orderinnchaoss/CANSAT-18/Team Kalpana-1.jpg

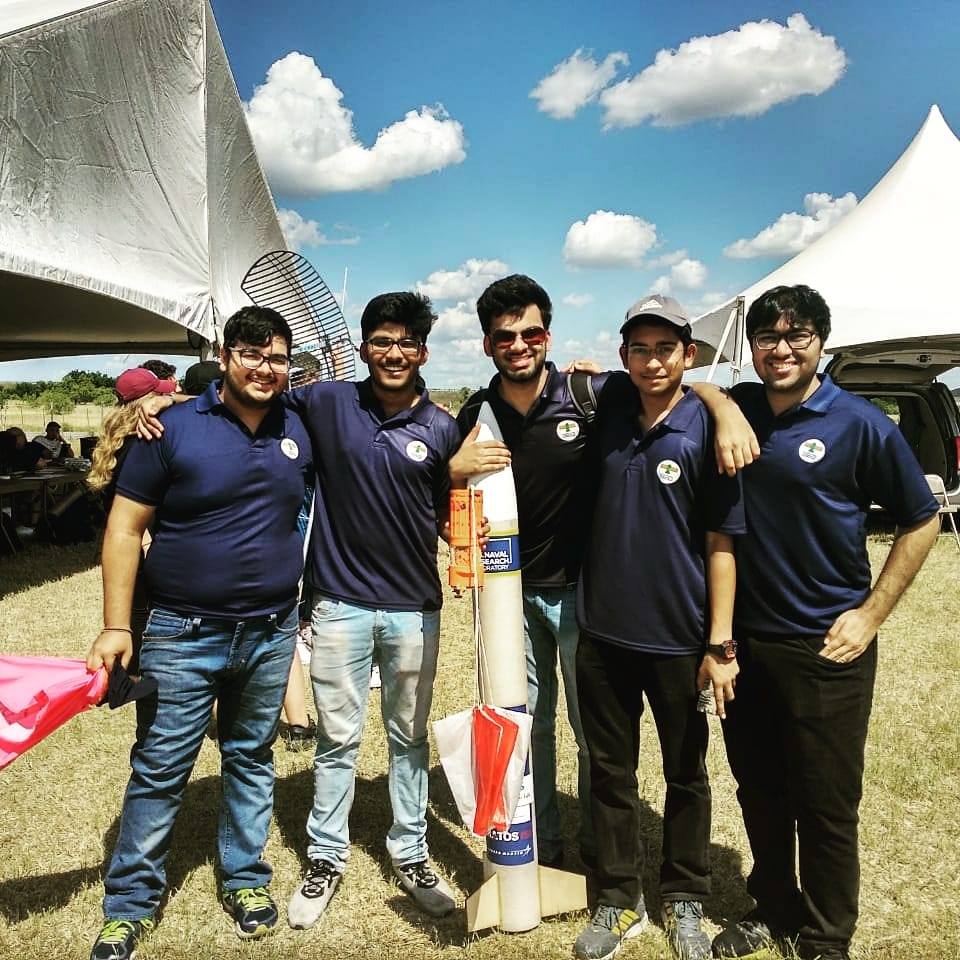
Team Kalpana-1.jpg
