orderinnchaoss/CANSAT-18/Cansat2018_2426_PFR_v01.pdf

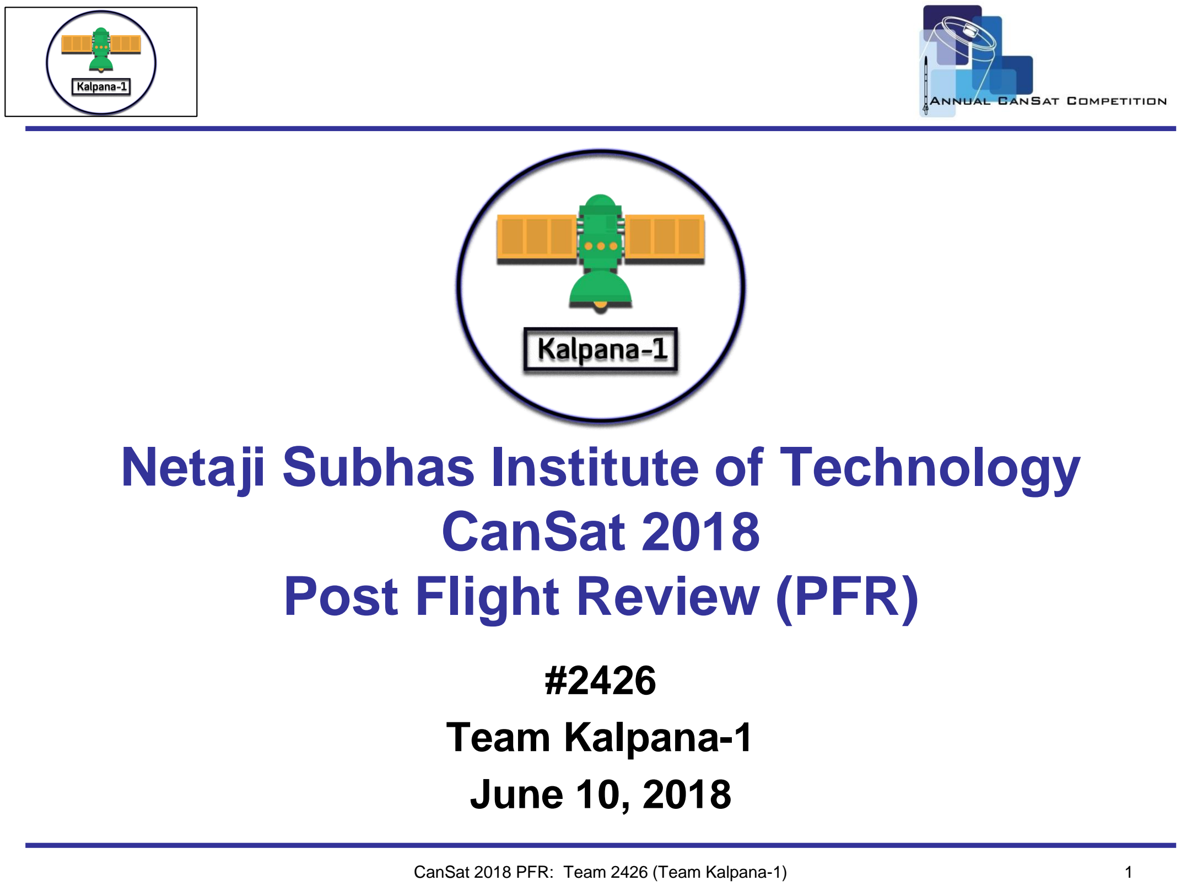
[picture p2: page 1]

CanSat 2018 PFR: Team 2426 (Team Kalpana-1) | 1

# Netaji Subhas Institute of Technology CanSat 2018 Post Flight Review (PFR)

#2426

# Team Kalpana-1 June 10, 2018

# Presentation Outline

# Introduction

# NAKUL AGGARWAL

# Presentation Outline

# - Introduction

## Presentation Outline

## Team Organization

# - Systems Overview

## Mission Summary

## Cansat Design Overview Cost of Cansat <$1000

## Physical Layout

# - Concept of Operations and Sequence of Events

## Planned and Actual CONOPS

## Planned and Actual SOE

Presenter: Nakul Aggarwal

# Presentation Outline

# - Flight Data Analysis

## Heatshield separation altitude

## Payload pressure sensor data plot

## Payload altitude plot

## Payload temperature sensor plot

## Payload GPS plot

## Payload battery power plot

## Tilt Sensor plot

## Wind sensor Data

## Camera Video

# - Failure Analysis

## Identification of failures, root causes, corrective actions

# - Lessons Learned

## Discussion of what worked and what didn’t

## Conclusions

Presenter: Nakul Aggarwal

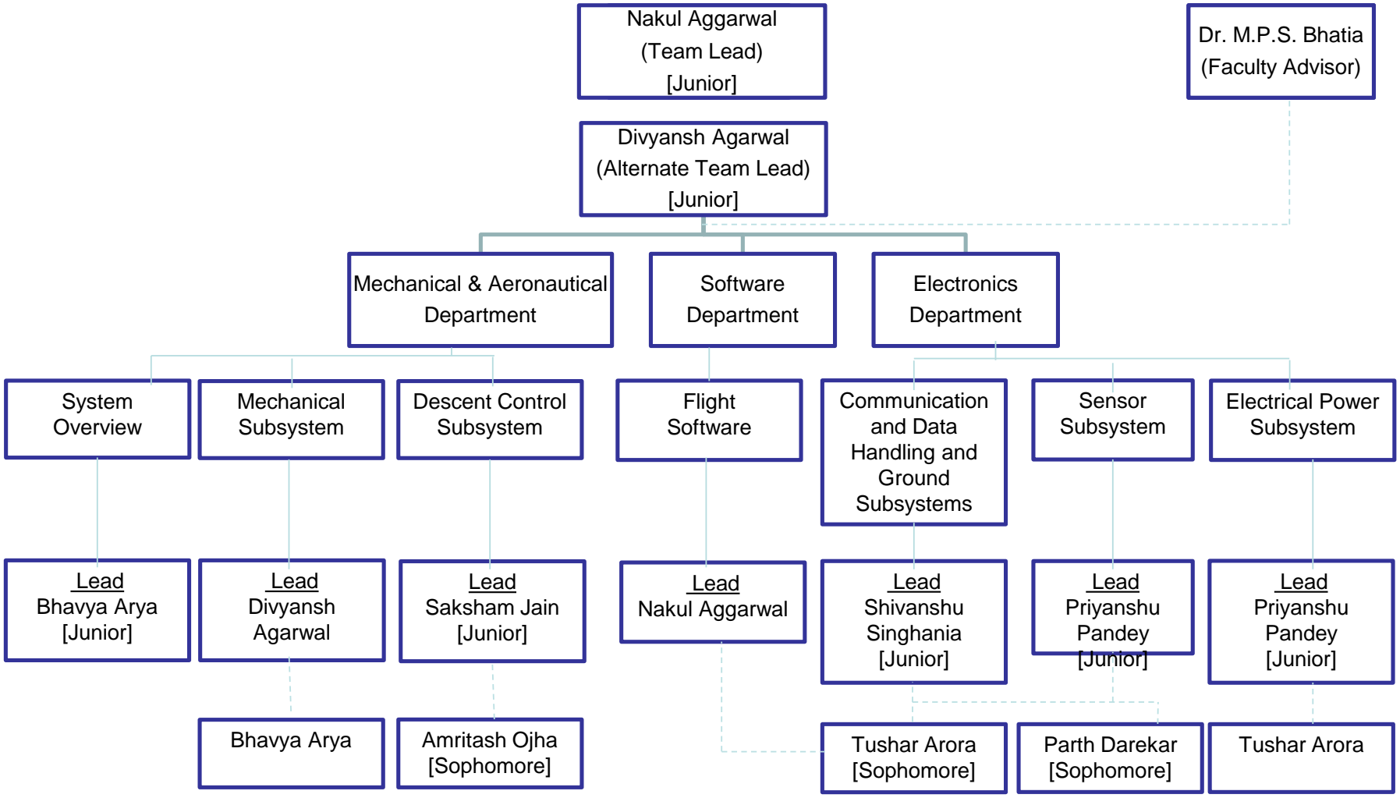
[picture p3: figure]
Divyansh Agarwal; (Alternate Team Lead); [Junior]; Mechanical & Aeronautical; Department; Software; Electronics; Mechanical Subsystem; Descent Control Subsystem; Nakul Aggarwal; (Team Lead); Dr. M.P.S. Bhatia; (Faculty Advisor); Flight Software; Lead Nakul Aggarwal; Tushar Arora; Lead Divyansh Agarwal; Lead Saksham Jain [Junior]; Bhavya Arya; Amritash Ojha; [Sophomore]; Sensor Subsystem; Communication and Data Handling and Ground Subsystems; Lead Shivanshu Singhania [Junior]; Parth Darekar [Sophomore]; Lead Priyanshu Pandey [Junior]; Electrical Power Subsystem; System Overview; Lead Bhavya Arya [Junior]; Tushar Arora [Sophomore]

CanSat 2018 PFR: Team 2426 (Team Kalpana-1)) | 5

# Team Organization

Presenter: Nakul Aggarwal

# Systems Overview

# BHAVYA ARYA

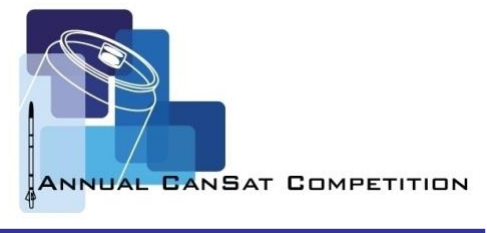
[picture p4: figure]

# Mission Summary

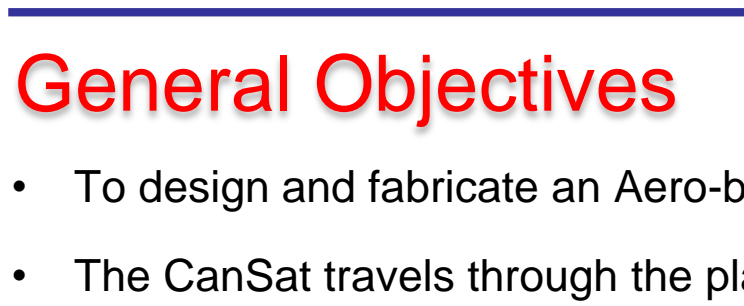
[picture p5: figure]
General Objectives
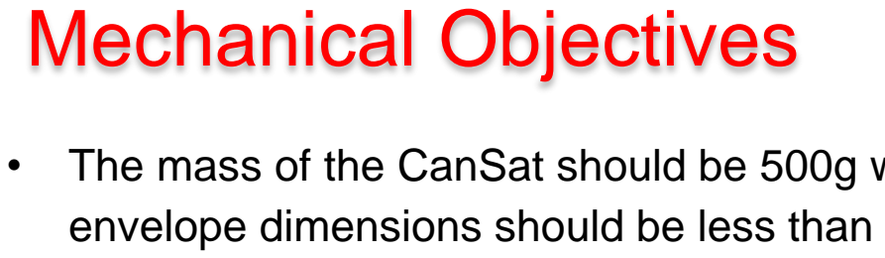
[picture p6: figure]
Mechanical Objectives

Presenter: Bhavya Arya

- To design and fabricate an Aero-braking Atmospheric Entry Probe (CanSat).

## - The CanSat travels through the planetary atmosphere sampling the atmospheric

composition during flight.

- CanSat consists of two important parts: Probe and Aero-braking Heat Shield.
- The probe shall hold a large hen's egg and protect it from damage from launch until landing

## - The mass of the CanSat should be 500g with a tolerance of +/-10g and the cylindrical

envelope dimensions should be less than 310 mm x 120 mm.

## - The probe shall accommodate a large hen’s egg with a mass ranging from 54 grams to 68 grams and a diameter of up to 50mm and length up to 70mm

- The heat shield must protect the probe in stowed configuration and maintain stability along nadir direction.

# Mission Summary

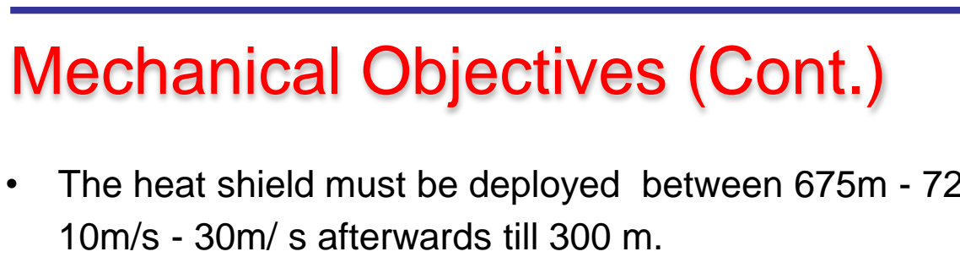
[picture p7: figure]
10m/s - 30m/ s afterwards till 300 m.; Mechanical Objectives (Cont.)
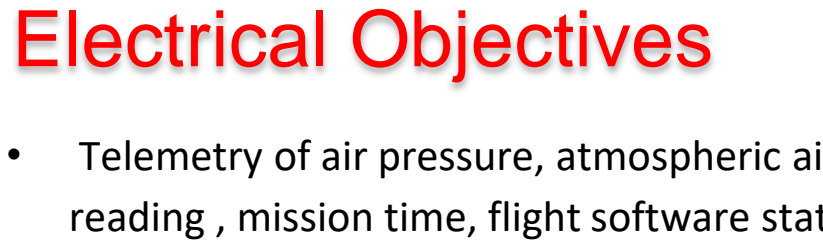
[picture p8: figure]
Electrical Objectives

Presenter: Bhavya Arya

## - The heat shield must be deployed between 675m - 725 m maintaining speed between

## - At 300 m, the heat shield should be removed and parachute is to be deployed. Parachute must reduce the speed of probe to 5m/s

- Telemetry of air pressure, atmospheric air temperature, altitude, voltage, GPS positions, tilt sensor reading , mission time, flight software state, should be collected and transmitted to the GCS at 1 Hz.
- All electronic components shall be enclosed and shielded from the environment with the exception of sensors.
- The probe must have easily accessible power switch and a power indicator.
- Probe should contain an audio beacon.

# Cansat Design Overview

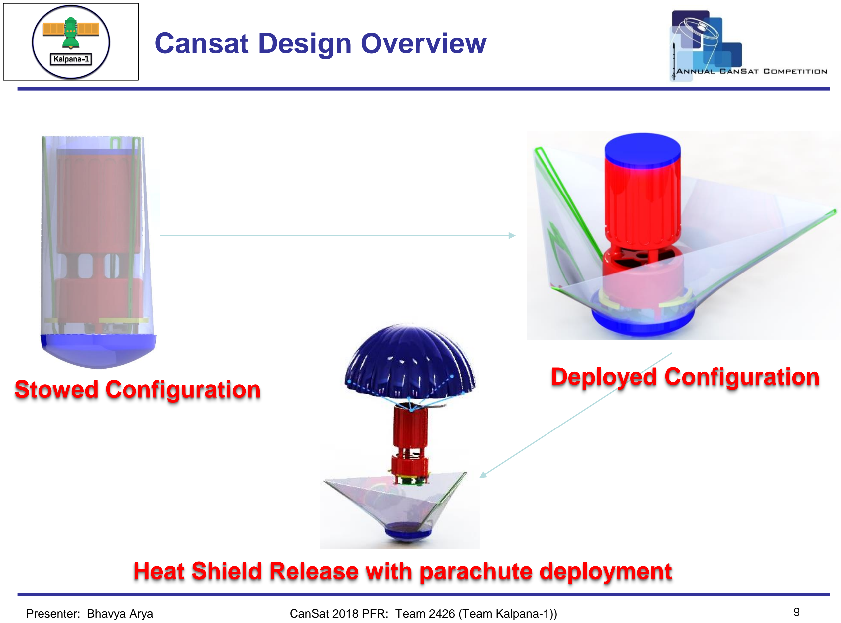
[picture p9: page 9]

CanSat 2018 PFR: Team 2426 (Team Kalpana-1)) | 9

# Stowed Configuration

# Heat Shield Release with parachute deployment

# Deployed Configuration

Presenter: Bhavya Arya

# Cansat Design Overview (Components Summary)

Presenter: Bhavya Arya | CanSat 2018 PFR: Team 2426 (Team Kalpana-1) | 10

# Electronics-1. BMP180 2. ADXL345 Tilt Sensor 3. UBLOX NEO 6M GPS Sensor 4. DS3231 RTC 5. XBEE Pro S2C 6. 2.4 GHz Patch Antenna 7. Voltage Sensor-Resistor 8. Switch 9. Audio Beacon-PiezoBuzzer 10.PCB 11.9V Lithium Ion Battery 1.2 Ah 12.7.74 V Lithium Ion Battery 2.8

Ah

# 13.Heat Sink 14.Regulator 15.Micro-Servo 9g Motors x 2

# Mechanical-1. Nylon PA-2200 Capsule 2. Ribs 3. Taffeta Nylon Flare Membrane 4. Gears x 2 5. Rotor with flanges 6. Egg Compartment 7. Ethylene Sheet for Battery Compartment 8. Tarc-20 Parchute 9. Philips Screws 10.Silicon Glue and Epoxy 11.Nylon 12 Probe

# Cansat Design Overview (Heat Shield Release Mechanism)

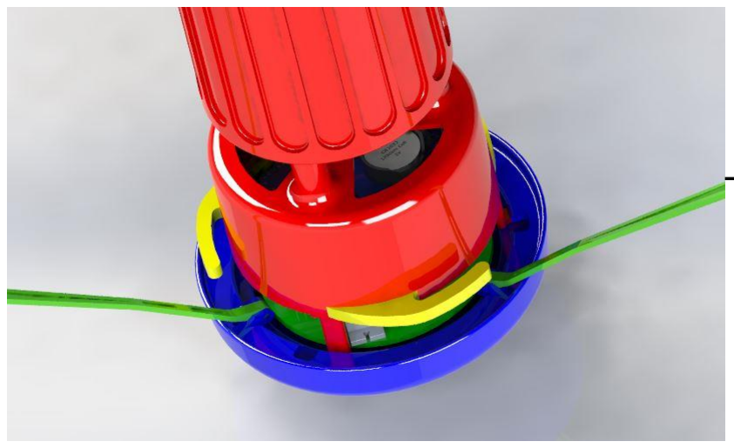
[picture p10: figure]

Presenter: Bhavya Arya

## Deployed Configuration

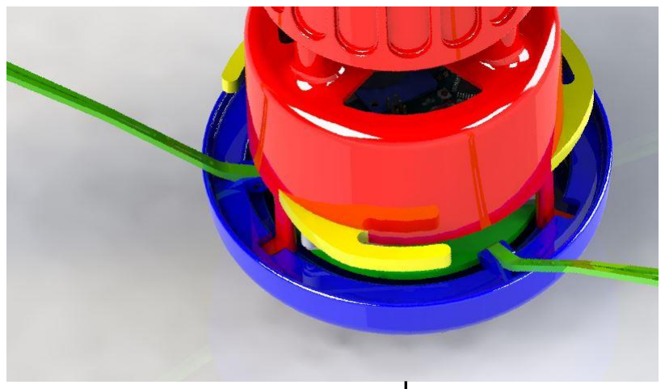
[picture p11: figure]

## After deployment, further rotation of capsule by servo aligns the L-hooks and cavity in the capsule surface

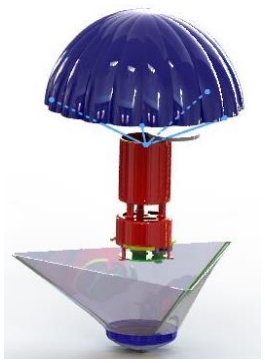
[picture p12: figure]

Due to upward force from parachute,

## the probe attains a relative velocity in the opposite direction which separates the

Probe and heat shield.

## Stage 1

## Stage 2

# Cansat Design Overview (Probe Parachute Release Mechanism)

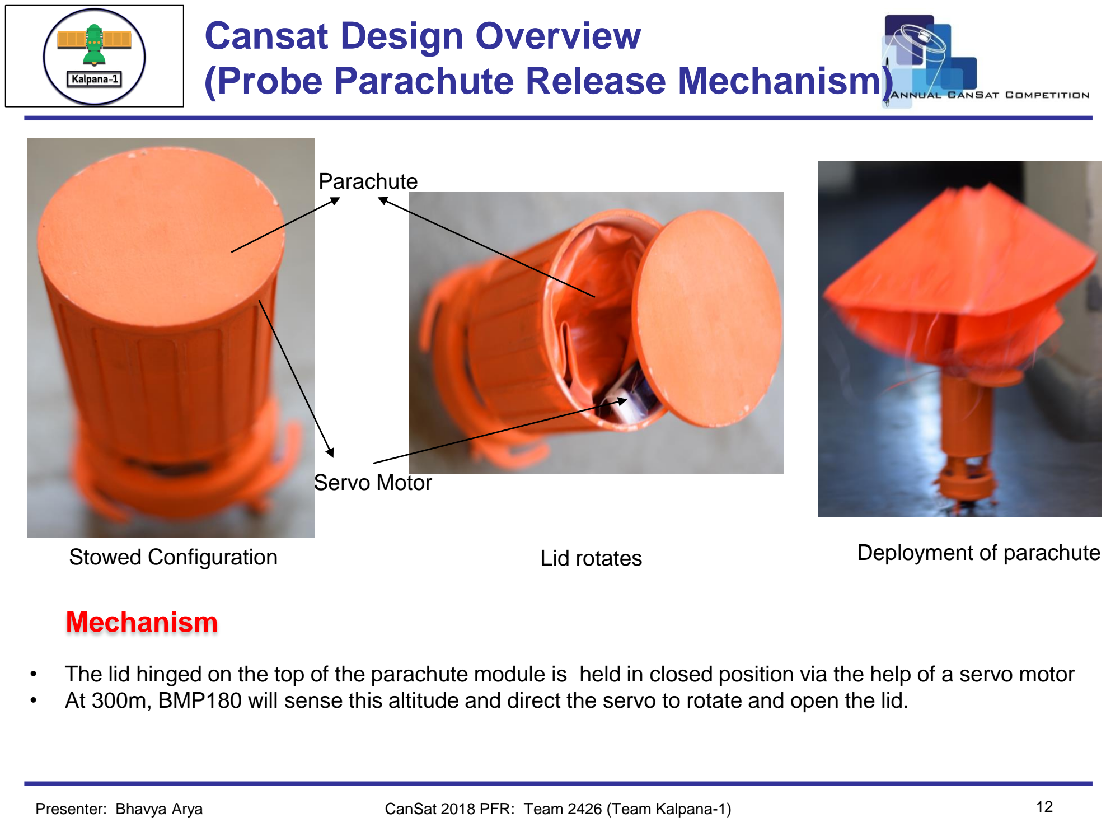
[picture p13: page 12]

- The lid hinged on the top of the parachute module is held in closed position via the help of a servo motor
- At 300m, BMP180 will sense this altitude and direct the servo to rotate and open the lid.

# Mechanism

## Stowed Configuration

## Parachute

Lid rotates | Deployment of parachute
Presenter: Bhavya Arya | CanSat 2018 PFR: Team 2426 (Team Kalpana-1) | 12

## Servo Motor

# Cansat Design Overview

## Strategy for insertion and removal of egg without complete disassembly

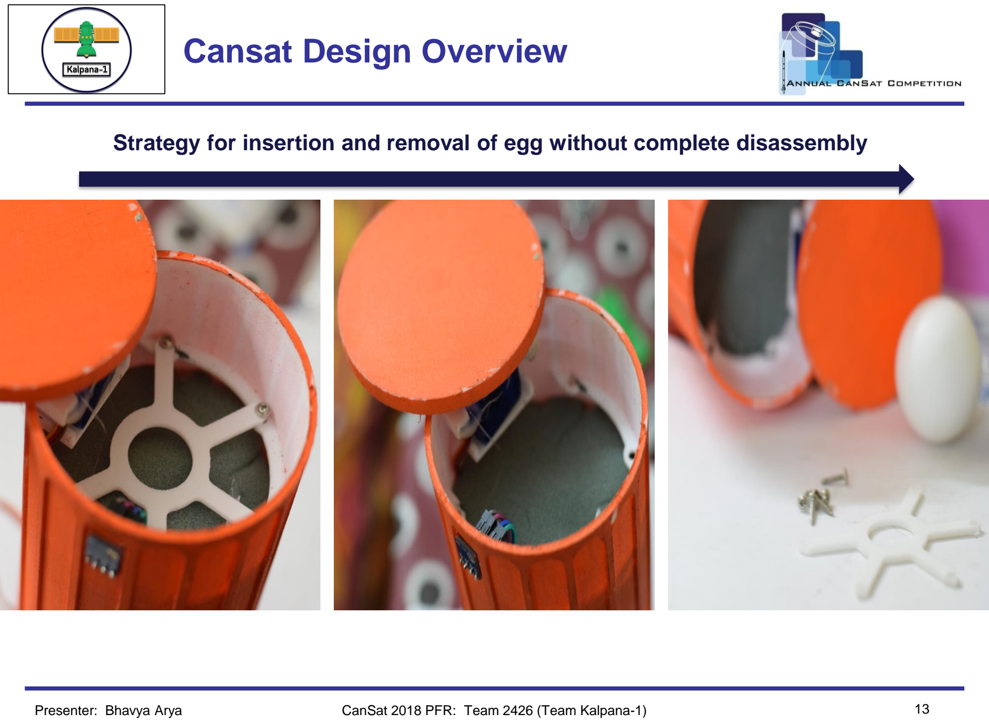
[picture p14: page 13]

Presenter: Bhavya Arya | CanSat 2018 PFR: Team 2426 (Team Kalpana-1) | 13

# CanSat Budget – Hardware (Electrical)

Presenter: Bhavya Arya

Part | Model | Quantity | Total Cost ($) | Determination
Microcontroller | Arduino Nano | 1 | $5.85 | Actual
Sensors | Air Pressure | BMP180 | 1 | $4.8 | Actual

## Temperature

Tilt Sensor | ADXL345 | 1 | $4.75 | Actual
Camera Sensor | Adafruit TTL Serial Camera | 1 | $40 | Actual
GPS Sensor | UBLOX NEO-6M | 1 | $15.13 | Actual
Power Voltage Sensor | Voltage Divider Circuit | 1 | $1 | Actual
XBEE Radio | XBEE Pro S2C | 1 | $41.61 | Actual
CanSat Antenna | FXP70 Freedom (Patch Antenna) | 1 | $4.52 | Actual
Audio Beacon | Mini Piezo Buzzer | 1 | $1 | Actual
Battery | Custom Designed Lithium 9V Battery | 2 | $30 | Actual
Servo Motor | Micro Servo (9g) | 2 | $6.96 | Actual
SD Card | SanDisk Class 10 | 1 | $9.42 | Actual
SD Card Module | Arduino SD Card Module | 1 | $4.7 | Actual
RTC | DS 3231 | 1 | $5.97 | Actual
Voltage Regulator | LM 7805(5V) | 1 | $2.5 | Actual
Total | $206.41

# CanSat Budget – Hardware (Electrical-Ground Station)

Presenter: Bhavya Arya

Part | Model | Quantity | Total Cost ($) | Determination
Ground Station Antenna | Yagi Antenna | 1 | $46.04 | Actual
Communication Module | XBEE Pro S2C | 1 | $41.61 | Actual
Base Circuit Boards | PCB | 1 | $10 | Actual
Others | | | $20 | Estimate
Total | $117.65

# CanSat Budget – Hardware (Mechanical)

Presenter: Bhavya Arya

Part | Model | Quantity | Total Cost ($) | Determination

## Probe

Container Body+Lid | 3D printed Nylon PA-2200 | 1 | $80 | Estimated
Parachute | Fruity Chutes TARC-18 | 1 | $38 | Actual
Rotor | 3D printed Nylon PA-2200 | 1 | $30 | Estimated

## Heat Shield

Flexible Capsule/Nose | 3D printed Nylon PA-2200 | 1 | $50 | Estimated
Flare Membrane | Tafetta Nylon Cloth | 1 m² | $80 | Estimated
Ribs | 3D printed Nylon PA-2200 | 6 | $20 | Estimated
Gearing Systems | 3D printed Nylon PA-2200 | 1 | $30 | Estimated

## Miscellaneous

Hinges, Lid, Torsional Springs, Hooks, Adhesives etc. | N.A. | N.A. | $50 | Estimated
| | | Total=$378

# CanSat Budget – Hardware (Total)

Presenter: Bhavya Arya

System | Cost($)
Electrical | $206.41
Mechanical | $378
Ground Station Costs | $117.65
Total Cost | $802.06

# Total Cost is well within the CanSat guidelines of $1000

# Cansat Physical Layout (Probe)

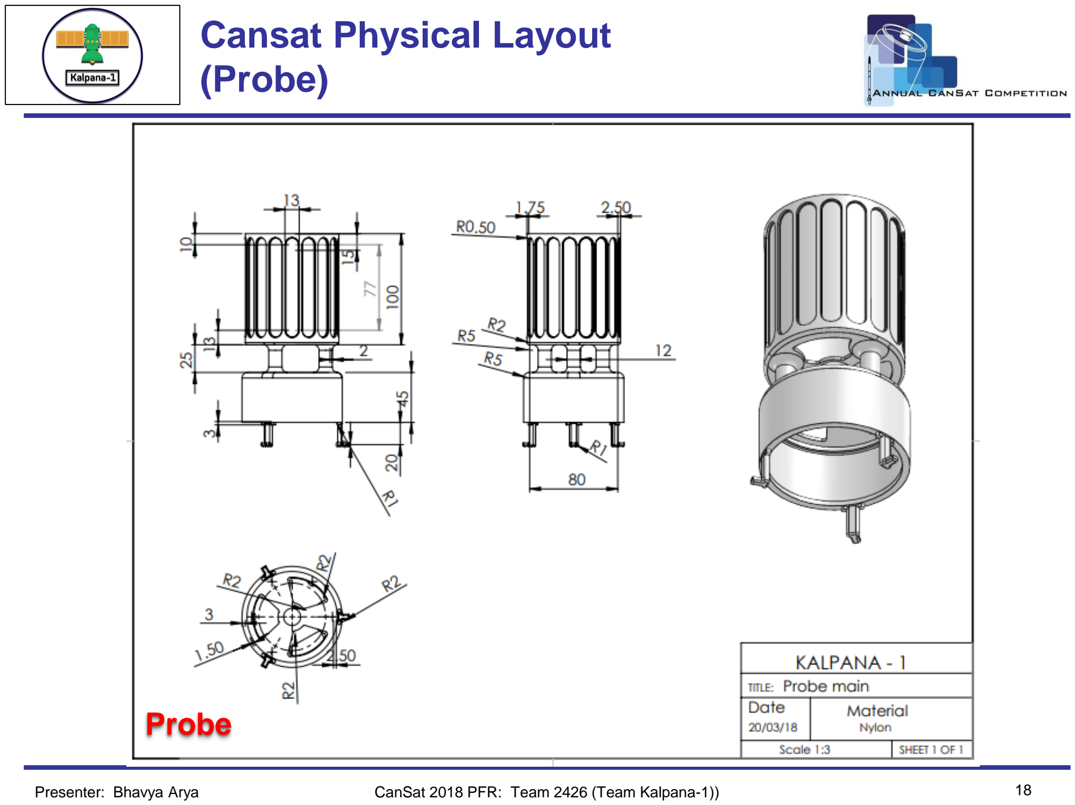
[picture p15: page 18]

CanSat 2018 PFR: Team 2426 (Team Kalpana-1)) | 18

# Probe

Presenter: Bhavya Arya

# Cansat Physical Layout (Egg Protection System)

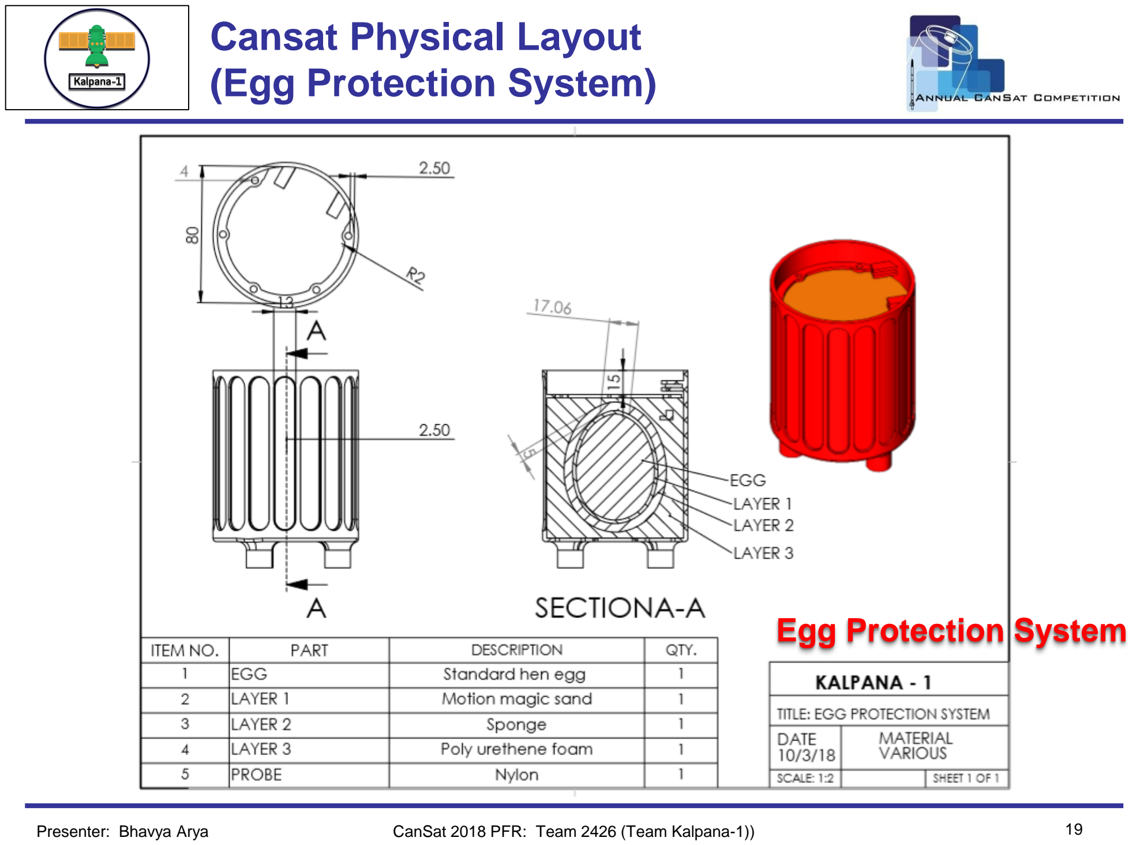
[picture p16: page 19]

CanSat 2018 PFR: Team 2426 (Team Kalpana-1)) | 19

# Egg Protection System

Presenter: Bhavya Arya

# Cansat Physical Layout (Heat Shield)

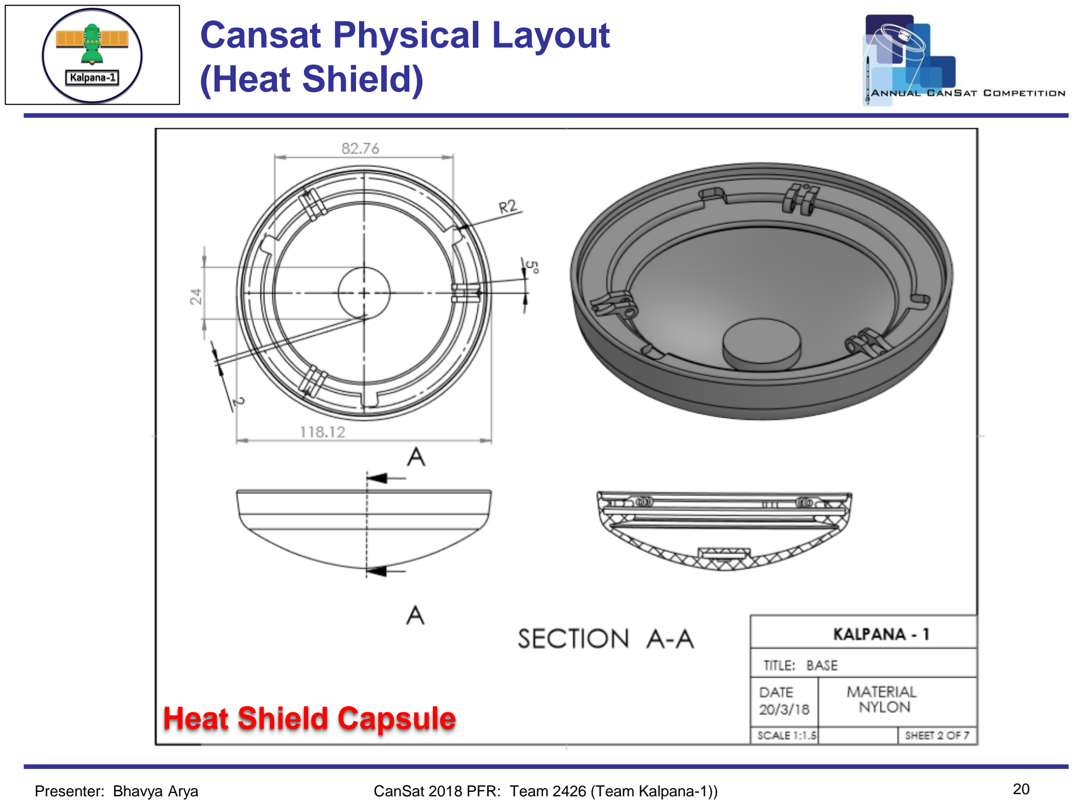
[picture p17: page 20]

CanSat 2018 PFR: Team 2426 (Team Kalpana-1)) | 20

# Heat Shield Capsule

Presenter: Bhavya Arya

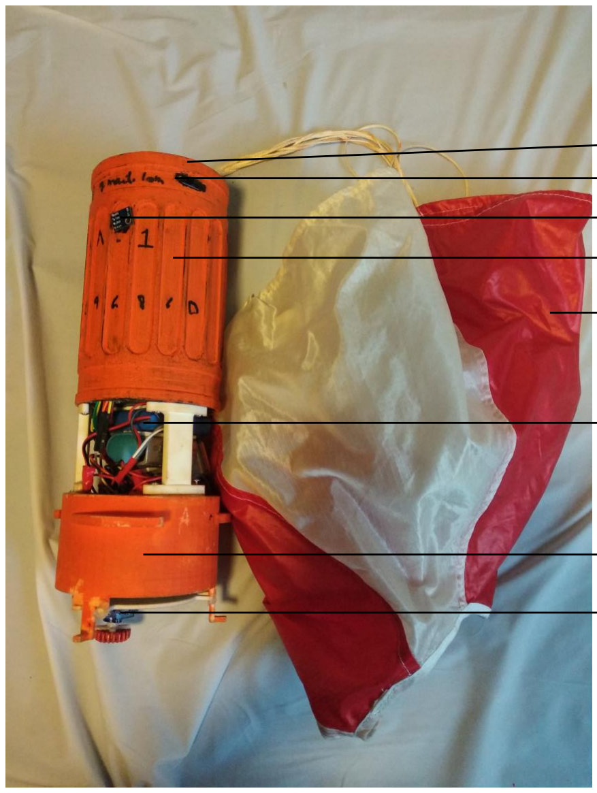
[picture p18: figure]

CanSat 2018 PFR: Team 2426 (Team Kalpana-1)) | 21

# Cansat Physical Layout (Probe)

Presenter: Bhavya Arya

## Battery Compartment

## Electronics Compartment

## Parachute

## Egg Compartment

## Power Switch

## BMP180

## Parachute Compartment

## SG90 Micro Servo 9g Motor

# Cansat Physical Layout (Probe)

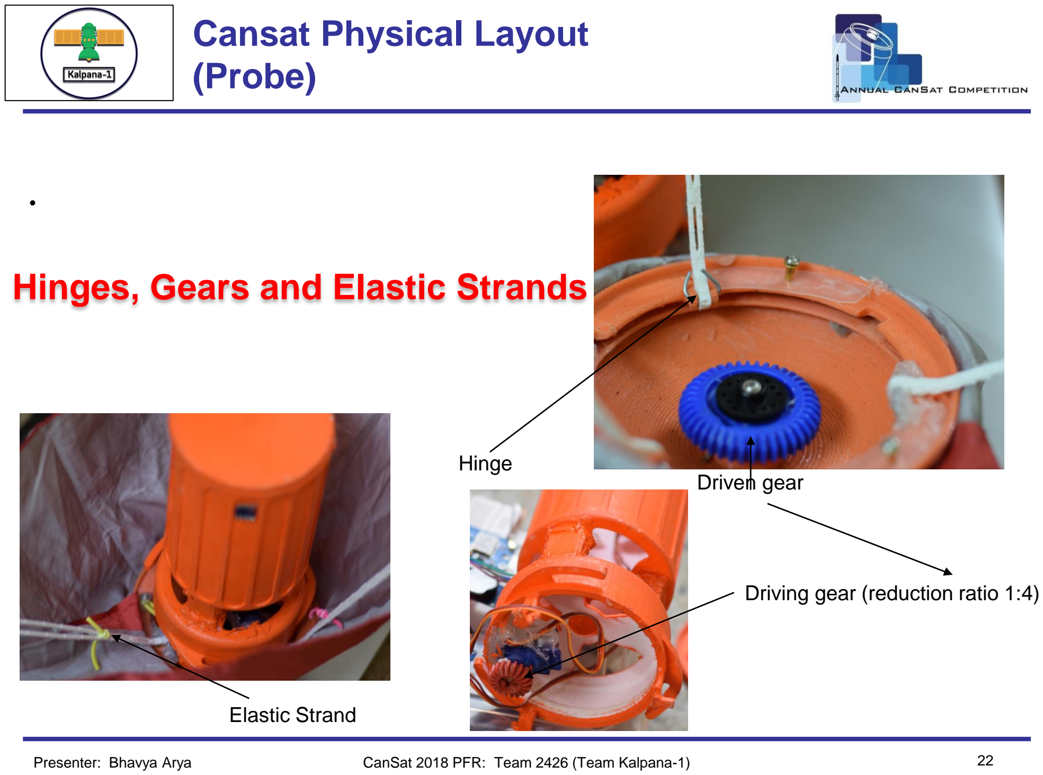
[picture p19: page 22]

Presenter: Bhavya Arya

# Hinges, Gears and Elastic Strands

•

## Hinge

## Driving gear (reduction ratio 1:4)

## Driven gear

## Elastic Strand

# Cansat Physical Layout (Heat Shield)

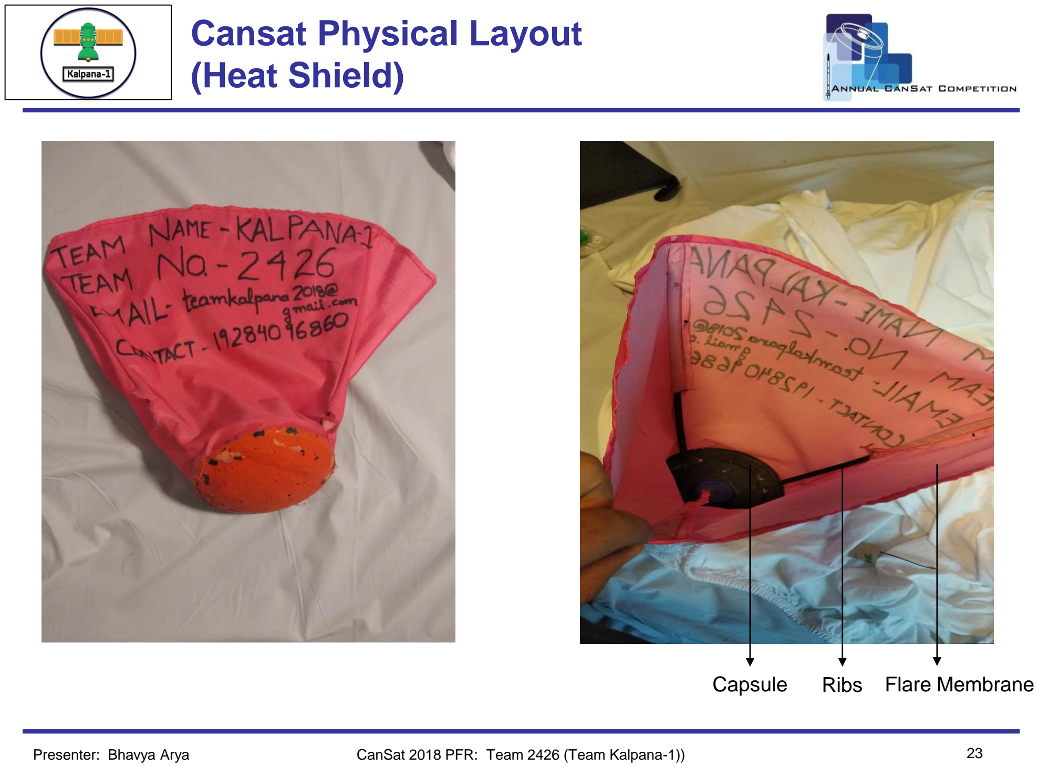
[picture p20: page 23]

CanSat 2018 PFR: Team 2426 (Team Kalpana-1)) | 23
Presenter: Bhavya Arya

## Capsule Ribs Flare Membrane

# Concept of Operations and Sequence of Events

# Nakul Aggarwal

# Planned CONOPS

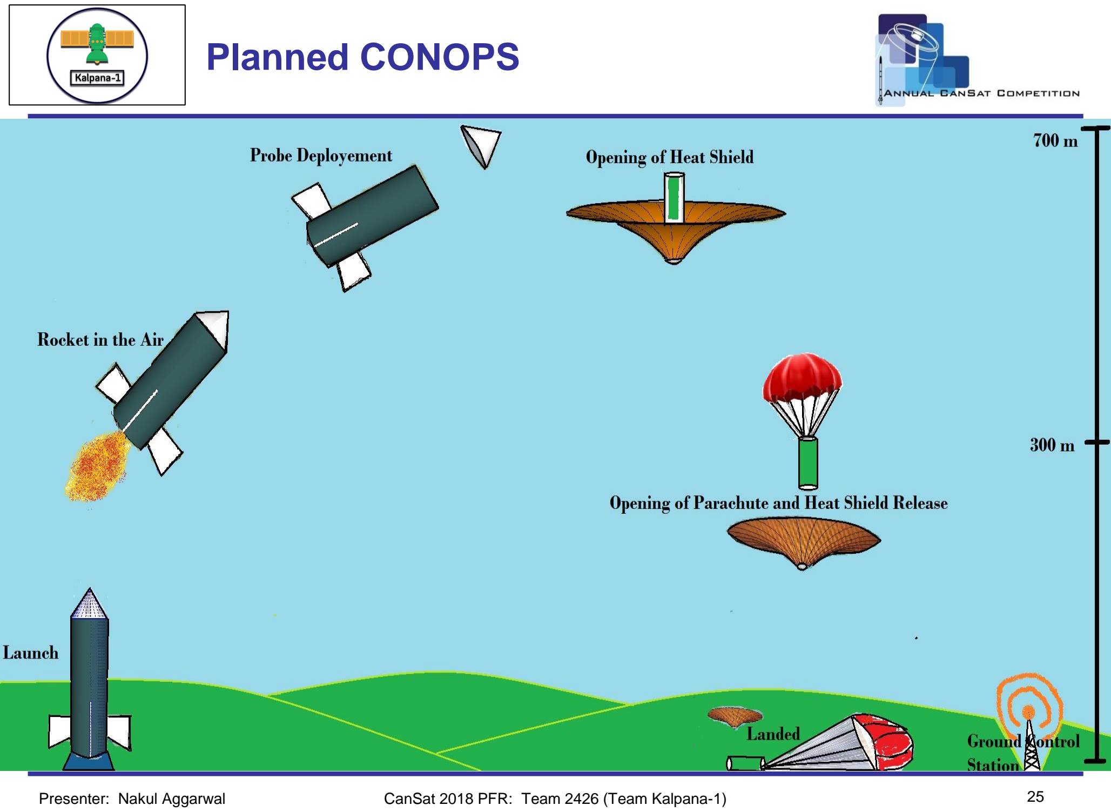
[picture p21: page 25]

Presenter: Nakul Aggarwal

# Planned CONOPS

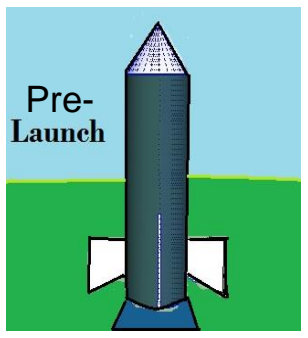
[picture p22: figure]
Pre-
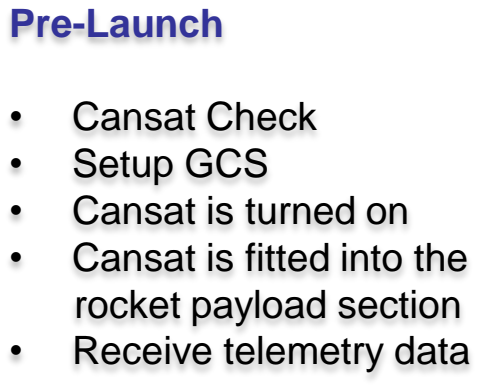
[picture p23: figure]
Pre-Launch; • Cansat Check • Setup GCS • Cansat is turned on • Cansat is fitted into the rocket payload section • Receive telemetry data

Presenter: Nakul Aggarwal

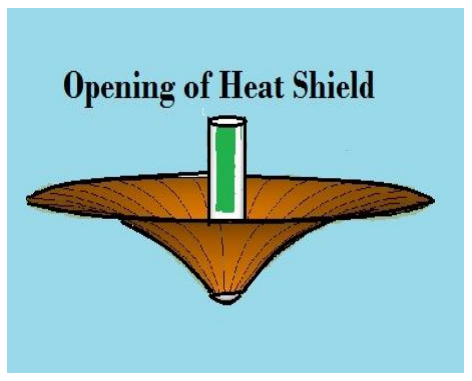
[picture p24: figure]
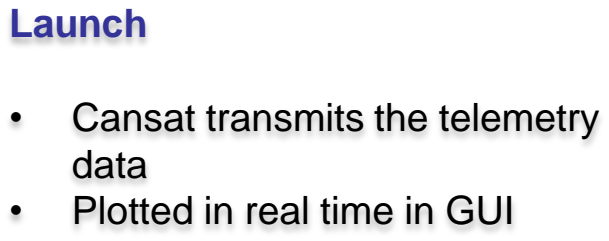
[picture p25: figure]
Launch; • Cansat transmits the telemetry data • Plotted in real time in GUI

## Cansat Deployment

## - Cansat is separated

from the rocket.

## - Heat Shield is deployed at

around 700m.

## - Due to the deployment of heat shield, the speed of

the Cansat reduces.

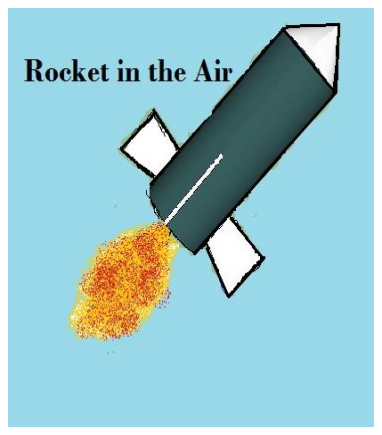
[picture p26: figure]

# Planned CONOPS

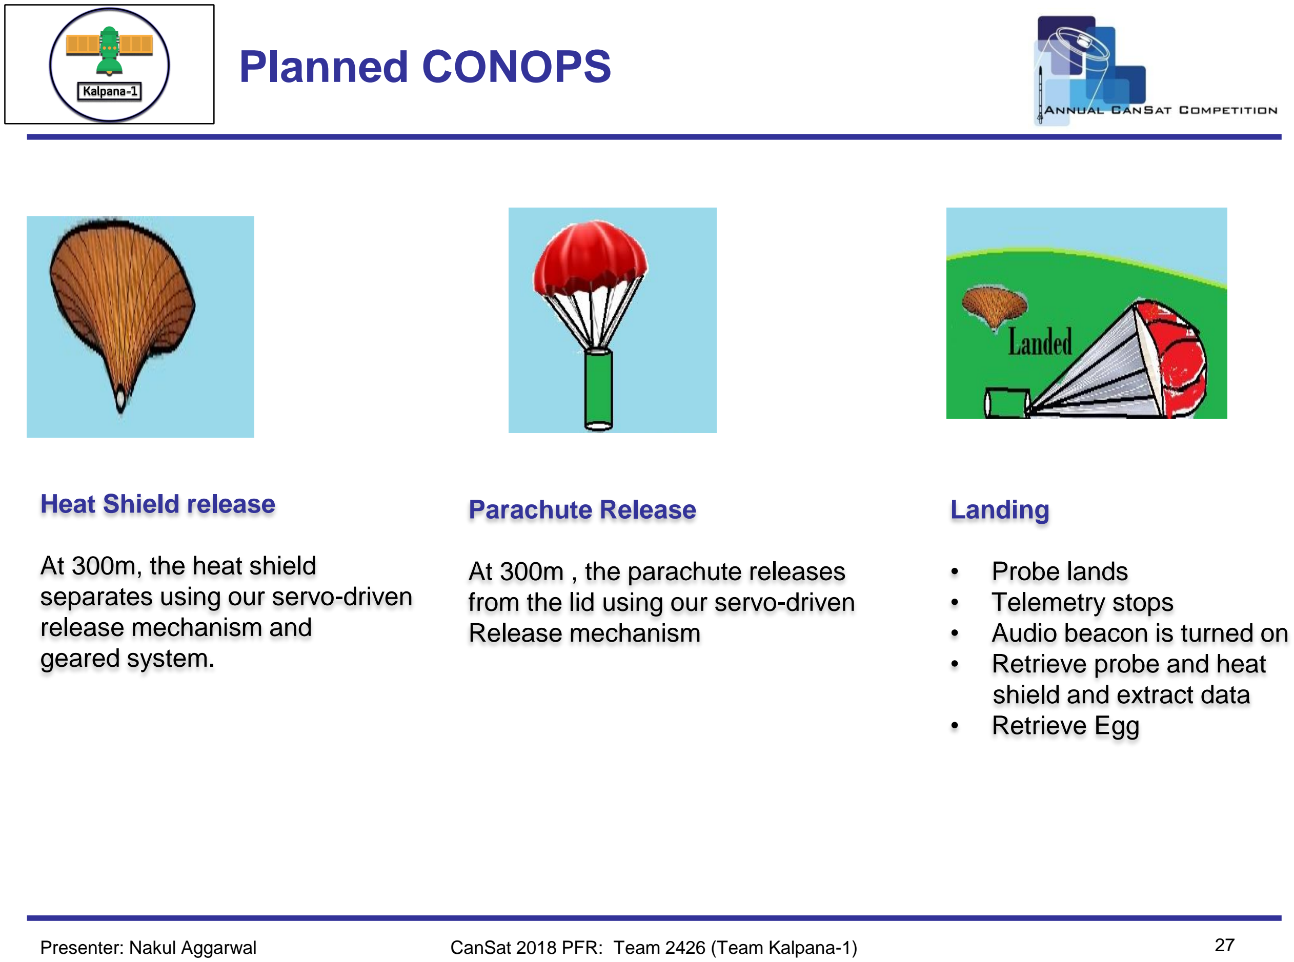
[picture p27: page 27]

Presenter: Nakul Aggarwal

## Heat Shield release

## At 300m, the heat shield separates using our servo-driven release mechanism and

geared system.

## Parachute Release

## At 300m , the parachute releases from the lid using our servo-driven Release mechanism

## Landing

## - Probe lands - Telemetry stops - Audio beacon is turned on - Retrieve probe and heat shield and extract data - Retrieve Egg

# Actual CONOPS

Presenter: Nakul Aggarwal

# - Heat Shield Release Heat shield release was successful and it got released mid-way. There was no physical

Damage to the heat shield.

# - Egg Survival

Egg survived with no cracks.

# - Parachute Release

Parachute release was successful and due to its deployment, the egg also survived. There was no physical damage to the Cansat.

# Planned SOE

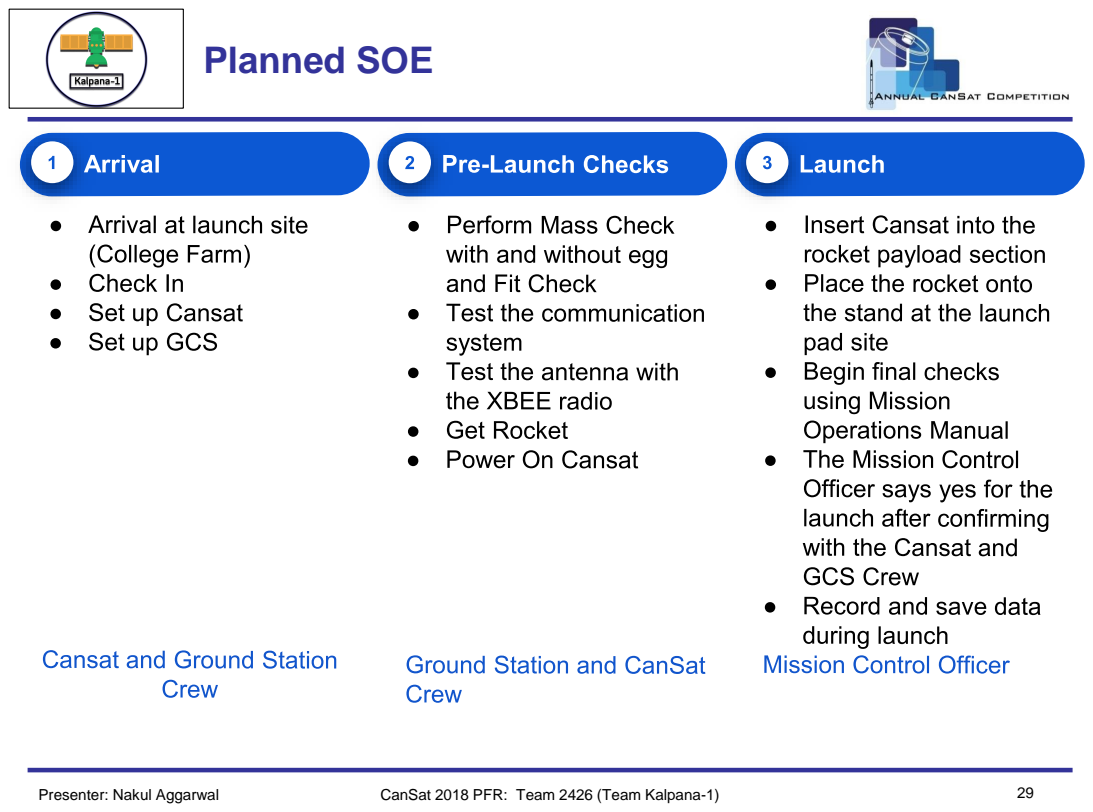
[picture p28: page 29]

Presenter: Nakul Aggarwal

# Planned SOE

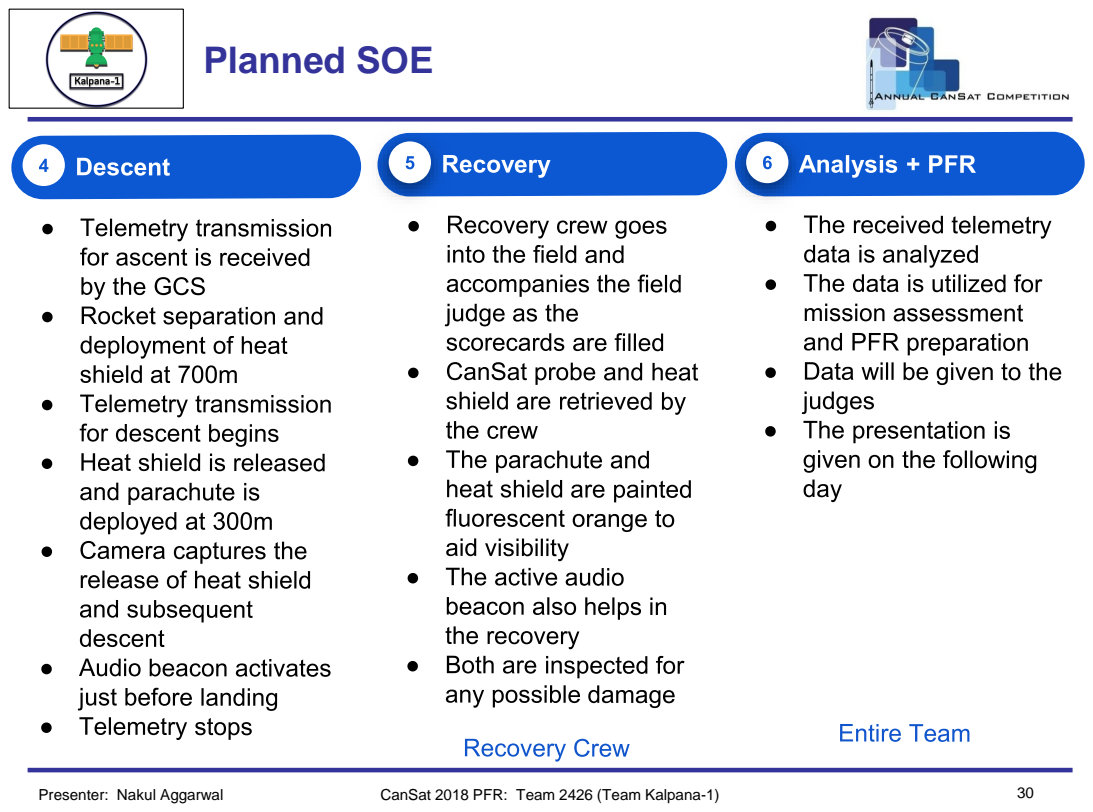
[picture p29: page 30]

Presenter: Nakul Aggarwal

# Actual SOE

Presenter: Nakul Aggarwal

# - Arrival Heat Shield was put in the correct position for its deployment and release using an initialization code

# - Pre-Launch Checks GCS, Cansat and Recovery Crew performed their operations successfully

# - Descent GCS Crew was able to collect telemetry only till the launch pad and no telemetry during the flight. Therefore, GCS Crew could plot the telemetry in real time only till the rocket was put in its stand at the launch pad

# - Recovery Successful Recovery of heat shield and probe

# - Data Retrieval Data was given to judges in a .csv file

# Flight Data Analysis

# Priyanshu Pandey

# Telemetry Packets

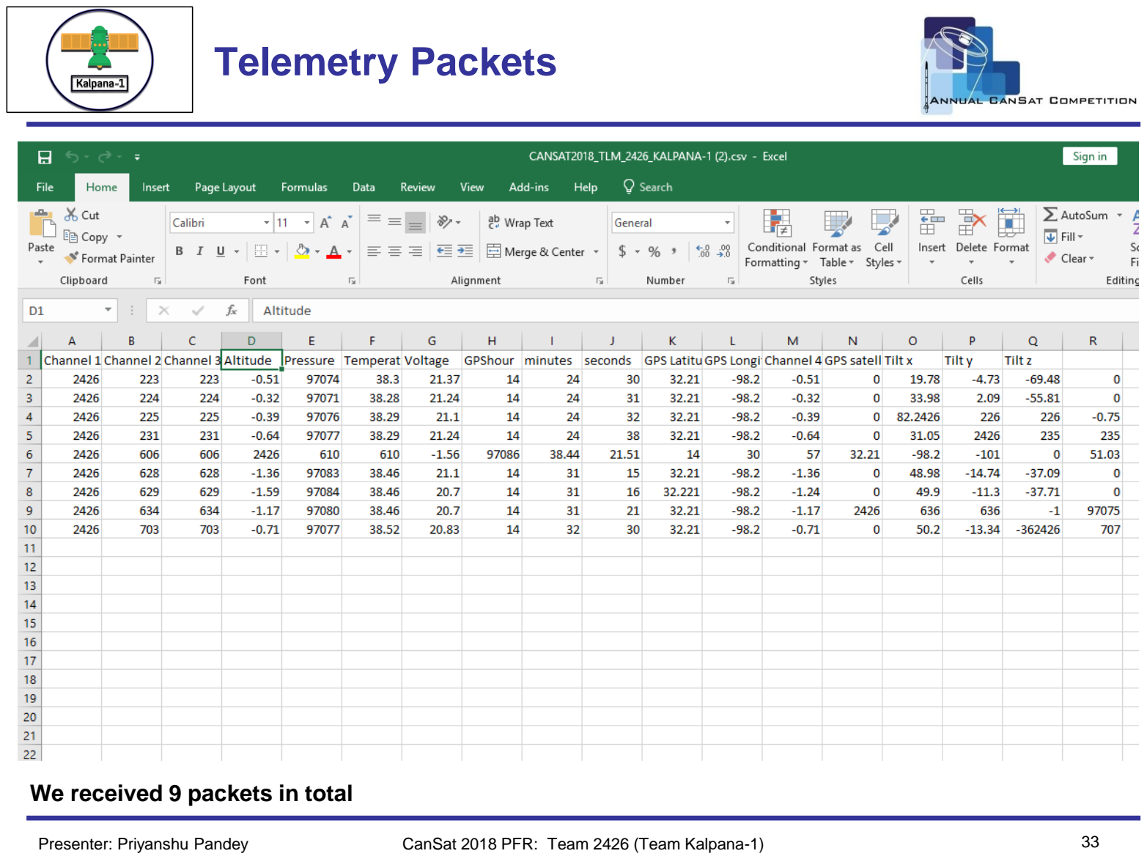
[picture p30: page 33]

Presenter: Priyanshu Pandey

## We received 9 packets in total

# Telemetry Packets (Saved in EEPROM of Arduino Nano)

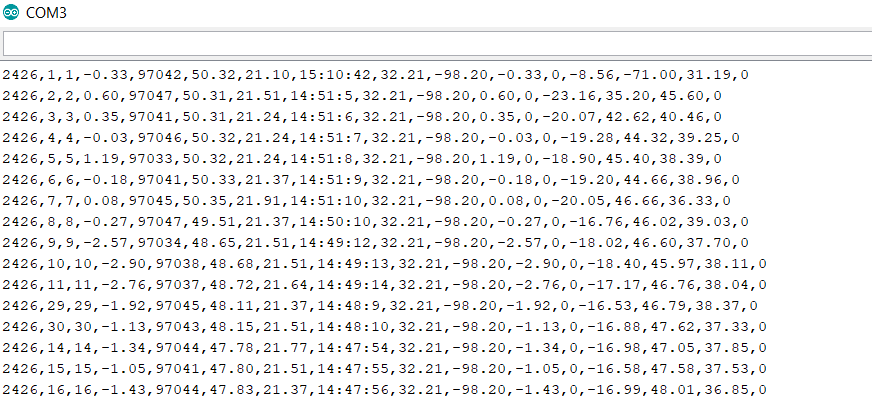
[picture p31: figure]

Presenter: Priyanshu Pandey

# Heat Shield separation altitude

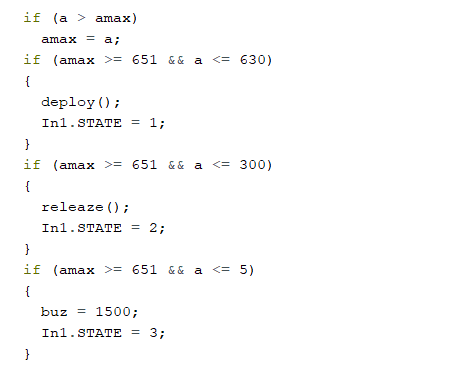
[picture p32: figure]

Presenter: Priyanshu Pandey

# Due to no telemetry received, we cannot tell with accuracy at what height the heat

shield got released. But on observation, it did get released around mid-way.

# Payload Pressure Sensor Data Plot

We received real time plotting for the 9 packets but after that no telemetry occurred. We showed

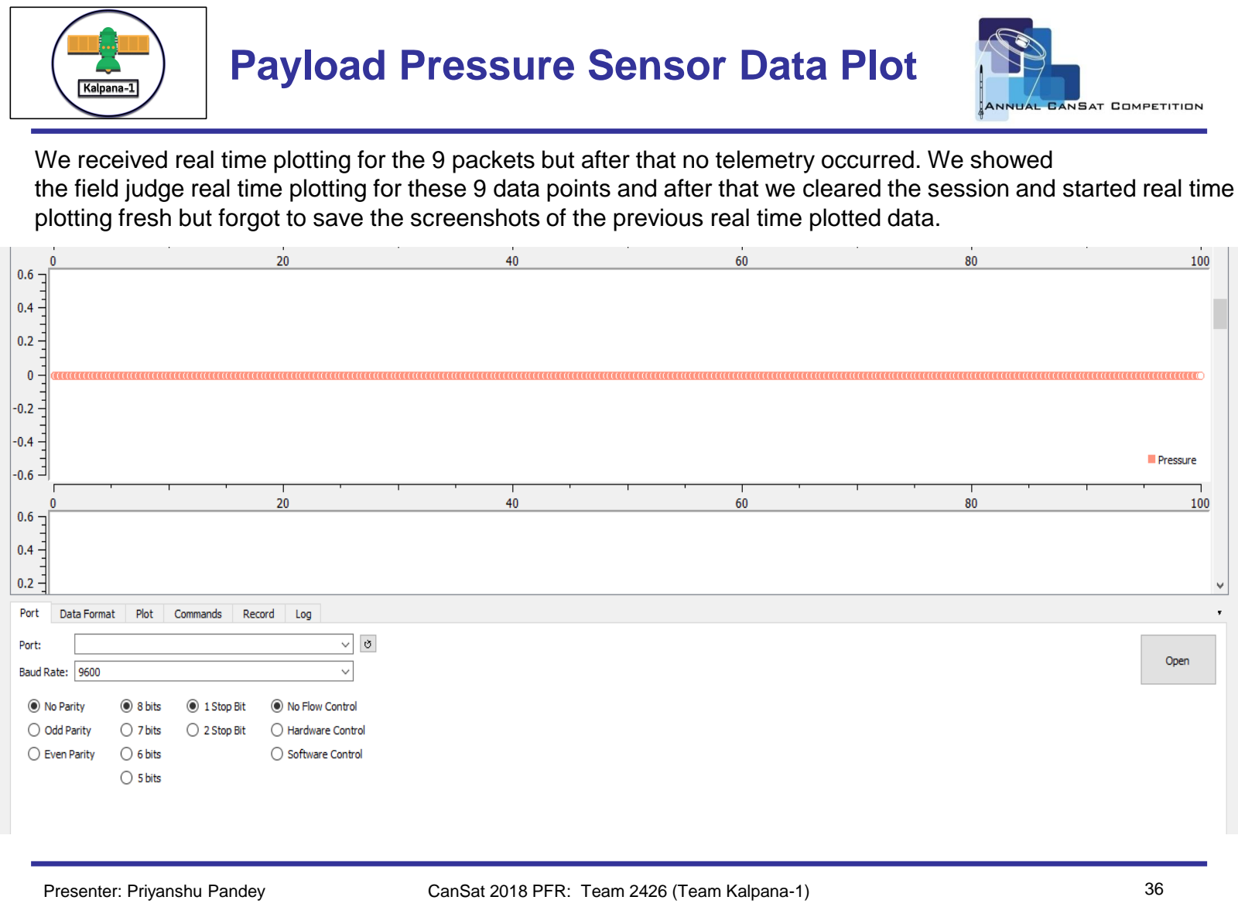
[picture p33: page 36]

Presenter: Priyanshu Pandey the field judge real time plotting for these 9 data points and after that we cleared the session and started real time plotting fresh but forgot to save the screenshots of the previous real time plotted data.

# Payload Altitude Plot

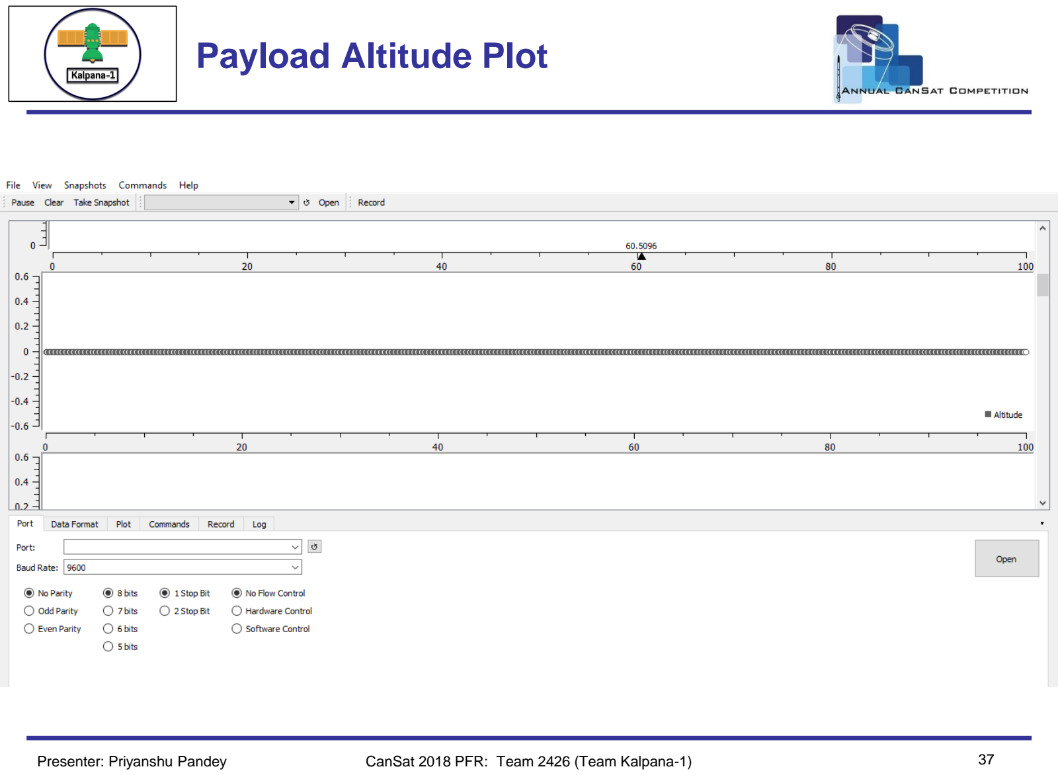
[picture p34: page 37]

Presenter: Priyanshu Pandey

# Payload Temperature Sensor Plot

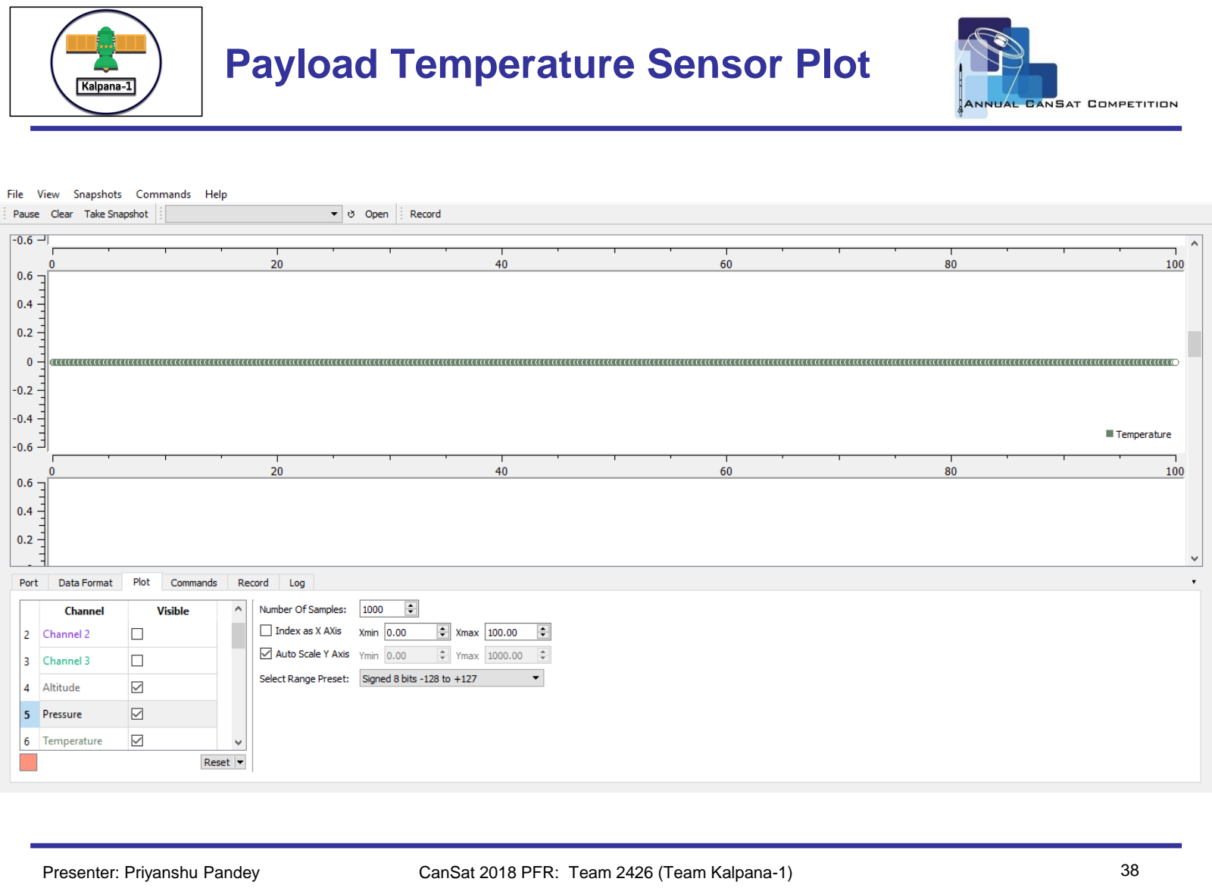
[picture p35: page 38]

Presenter: Priyanshu Pandey

# Payload GPS Plot

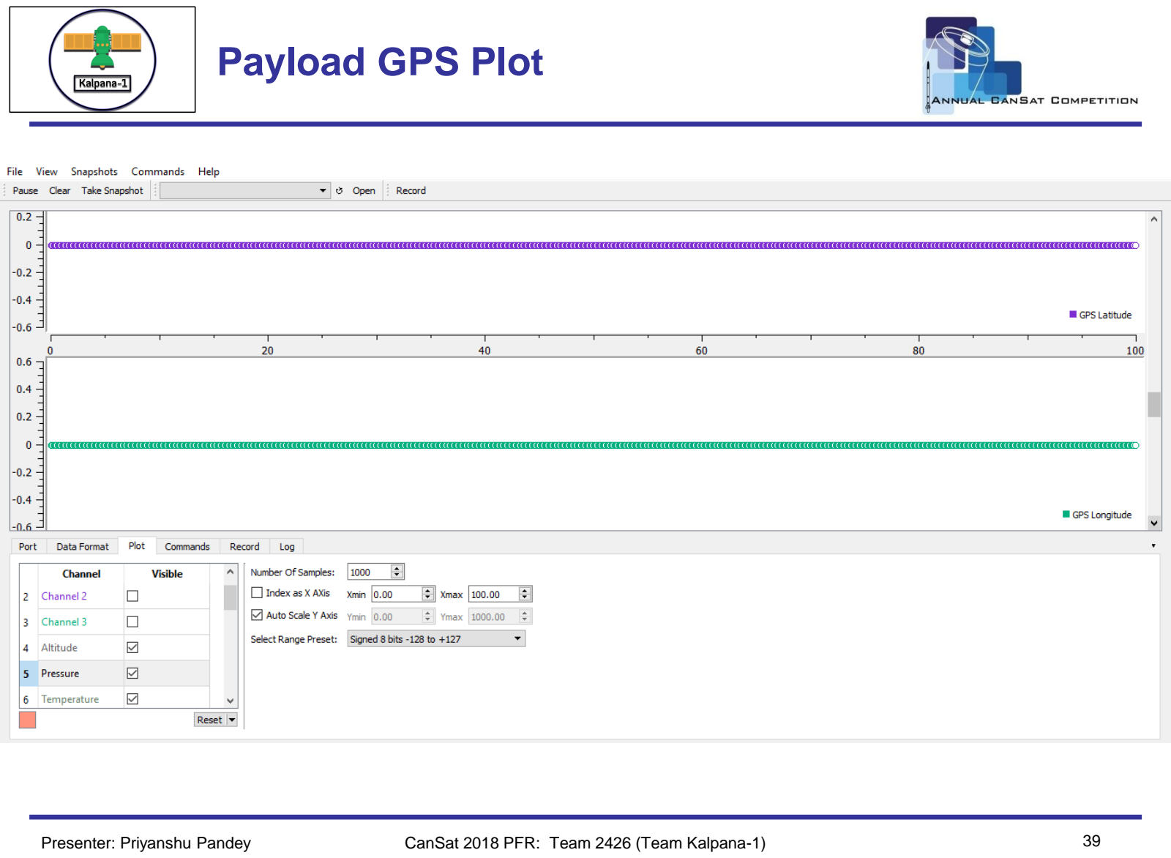
[picture p36: page 39]

Presenter: Priyanshu Pandey

# Payload Battery Power Plot

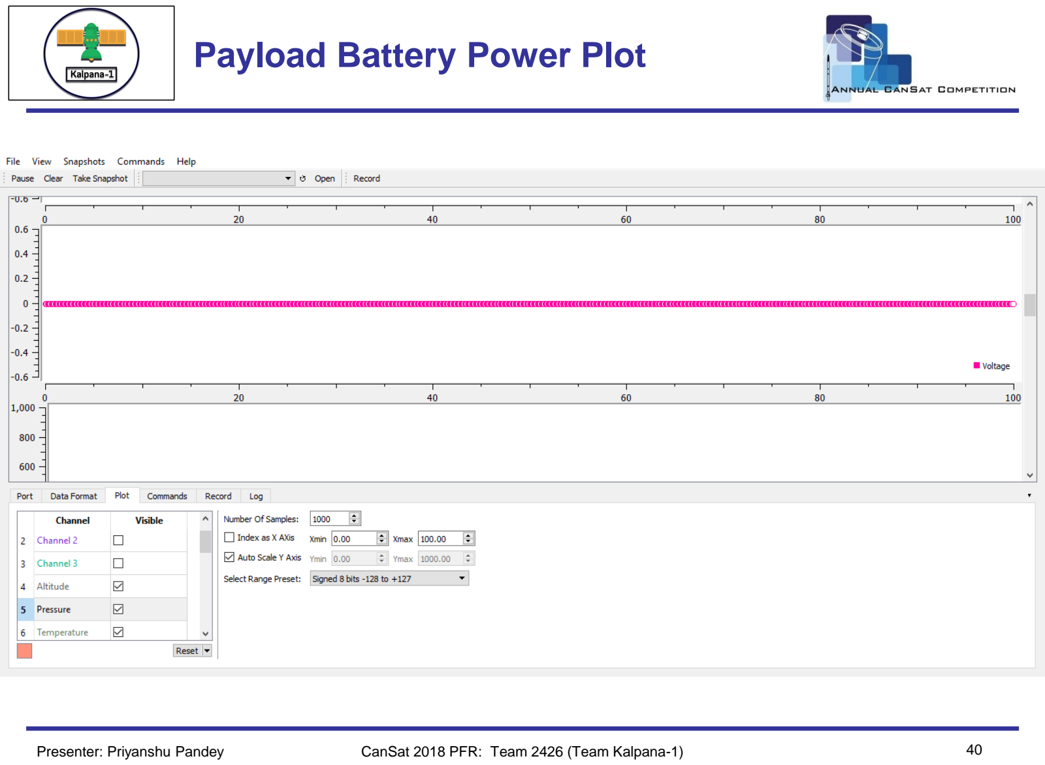
[picture p37: page 40]

Presenter: Priyanshu Pandey

# Tilt Sensor Plot

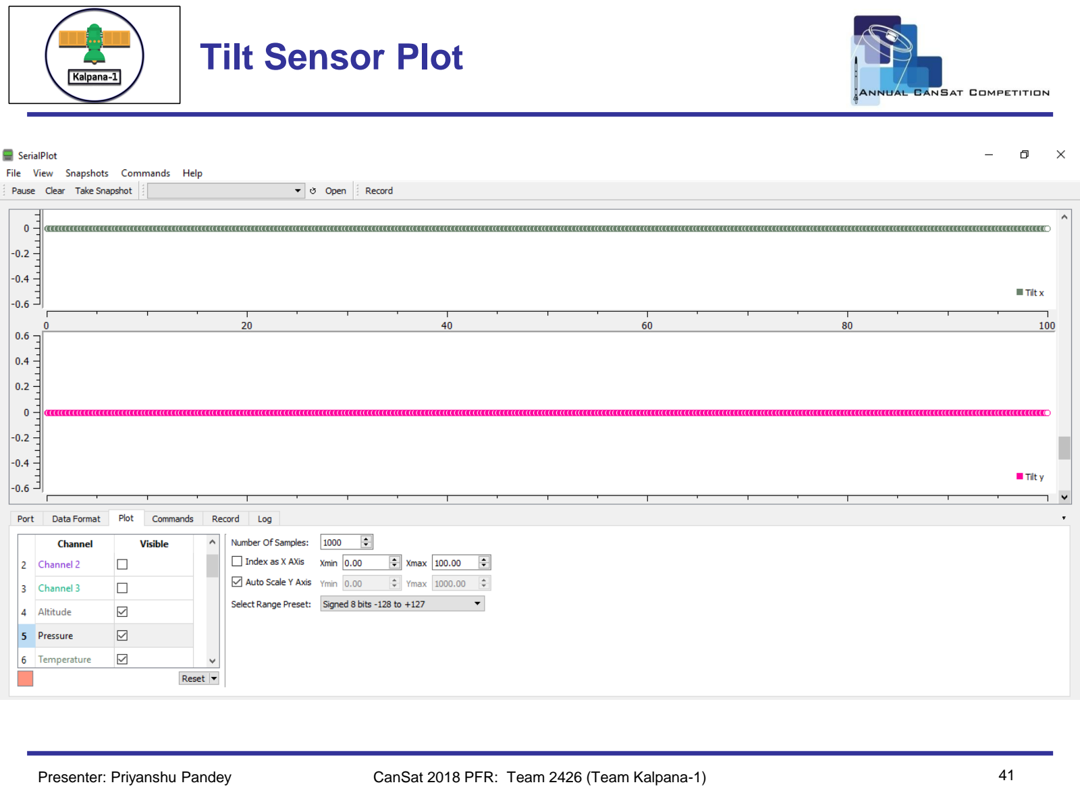
[picture p38: page 41]

Presenter: Priyanshu Pandey

# Wind Sensor Plot

Presenter: Priyanshu Pandey

## We didn’t attempt this bonus due to weight constraints

# Camera Video

Presenter: Priyanshu Pandey

## We couldn’t attempt this bonus due to latency caused in telemetry

# Failure Analysis

# Saksham Jain

# Identification of Failures and Root Causes

Presenter: Saksham Jain

Sr. No. | Failures | Root Cause
1. | No telemetry | The 2.4 GHz Yagi Antenna (13dbi) got stuck at the London Heathrow Airport and we didn’t receive that baggage until 8 th afternoon and the connectors inside it were missing. So, we received those packets using a 900 MHz Yagi antenna at the receiver side and 2.4 GHz Patch antenna at the transmitter side.
2. During recovery, the audio | beacon wasn’t loud enough. | The audio beacon was muffled due to the Cansat’s outside covering

# Corrective Actions

Presenter: Saksham Jain

Sr. No. | Failures | Corrective Actions
1. | No telemetry | Next time, we will take extra care and precaution while shipping things at the next competition site. We should have brought an extra Yagi antenna and instead shipped to USA directly. We should not have carried it with us. We should also have saved the data in an SD Card separately since EEPROM of Arduino Nano has very small memory space.
2. | The lid fell off. | The lid should have been mounted properly using the screw on top.
3. During recovery, the audio | beacon had a very faint voice. | Better choice of audio beacon which is loud enough.

# Lessons Learned

# Parth Hemant Darekar

# What Worked

Presenter: Parth Hemant Darekar | CanSat 2018 PFR: Team 2426 (Team Kalpana-1)) | 48

# 1. The Cansat passed all the environmental results and the fit check as well due to 10 mm tolerance along the height

and 6 mm tolerance along the diameter.
2. The heat shield got deployed and released successfully.

# 3. The parachute deployed successfully, thus reducing the speed and swaying of the Cansat

4. The egg survived with no cracks.

# 5. A total of 9 packets were received at the ground station for which there was successful real-time plotting on the GUI 6. The heat shield did not break on landing 7. The probe had no physical damage and it was fully

functional and could be used again for another flight.

# What didn’t work

Presenter: Parth Hemant Darekar | CanSat 2018 PFR: Team 2426 (Team Kalpana-1)) | 49

# 1. We only received the telemetry during pre-flight 2. Audio beacon wasn’t loud enough to help in the recovery

process.

# 3. We couldn’t attempt the Camera bonus sensor as was planned

earlier due to latency caused in the rest of the telemetry.

# Conclusions

Presenter: Parth Hemant Darekar | CanSat 2018 PFR: Team 2426 (Team Kalpana-1)) | 50

# 1. The launch was successful except only the telemetry 2. We were worried about the tumbing of the Cansat but it worked pretty well

after the deployment of the parachute.

# 3. Huge amount of time and research was given to deployment and release phases and multiple prototypes were made which helped in the success of

the launch.

# 4. We did not give much attention to the shipping and transportation which

we will next time.

# 5. Since it was our first time to Cansat competition, we thank all the organizers and professors for helping us and imparting in-depth

knowledge about the rocket and satellite launch.
