orderinnchaoss/CANSAT-18/SchBrds/Cansat 2018_V2 (1).brd

## EAGLE design SchBrds/Cansat 2018_V2 (1).brd (2018-11-05)

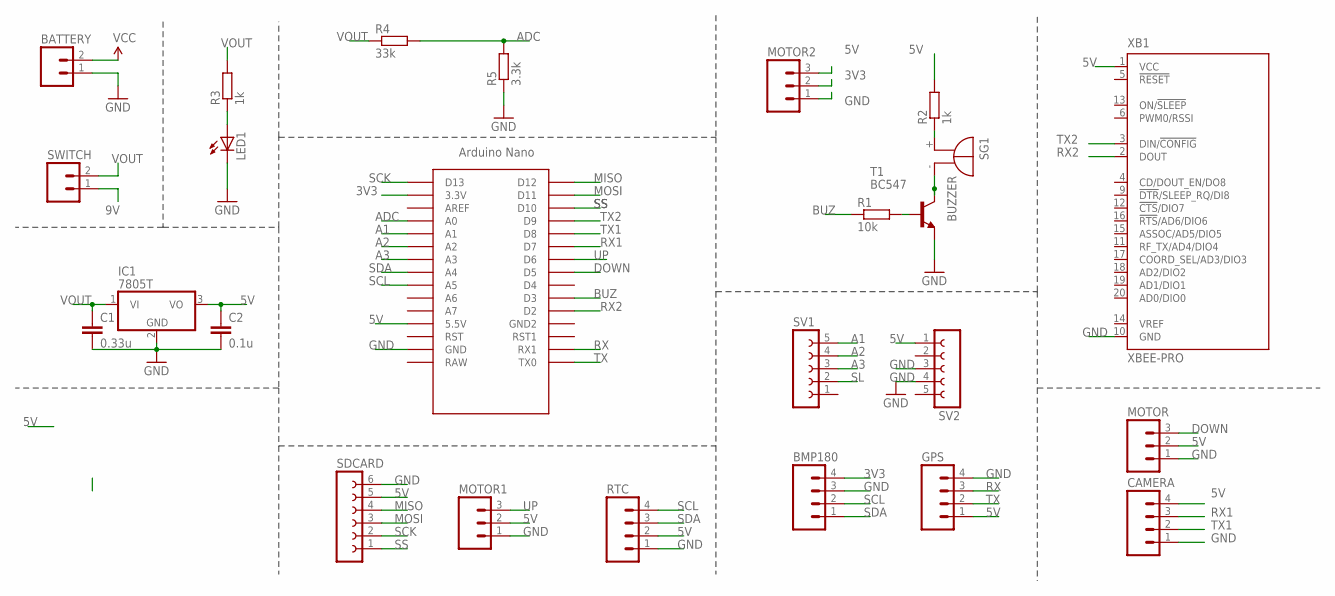
[picture p39: schematic Cansat 2018_V2 (1).sch]

Parts:
BATTERY: M02; 02P
BMP180: M04; 04P
C1: 0.33u; C0805
C2: 0.1u; C0805
CAMERA: M04; 04P
GPS: M04; 04P
IC1: 7805T; TO220H
LED1: LED3MM
MOTOR, MOTOR1, MOTOR2: M03; 03P
R1: 10k; 0207/7
R2: 1k; 0207/7
R3: 1k; 0204/7
R4: 33k; 0207/7
R5: 3.3k; 0207/10
RTC: M04; 04P
SDCARD: FE06-1; FE06
SG1: BUZZER; F/TMB
SV1, SV2: FE05-1
SWITCH: M02; 02P
T1: BC547; TO92
U$1: NANO
XB1: XBEE-PRO

Connections:
3V3: BMP180.4, MOTOR2.2, U$1.3.3V
5V: C2.1, CAMERA.4, GPS.1, IC1.3 (VO), MOTOR.2, MOTOR1.2, MOTOR2.3, R2.2, RTC.2, SDCARD.5, SV2.1, U$1.5V (5.5V), XB1.1 (VCC)
9V: BATTERY.2, SWITCH.1
A1: SV1.5, U$1.A1
A2: SV1.4, U$1.A2
A3: SV1.3, U$1.A3
ADC: R4.2, R5.2, U$1.A0
BUZ: R1.1, U$1.D3
DOWN: MOTOR.3, U$1.D5
GND: BATTERY.1, BMP180.3, C1.2, C2.2, CAMERA.1, GPS.4, IC1.2 (GND), LED1.K (C), MOTOR.1, MOTOR1.1, MOTOR2.1, R5.1, RTC.1, SDCARD.6, SV2.3, SV2.4, T1.1 (E), U$1.GND, XB1.10 (GND)
MISO: SDCARD.4, U$1.D12
MOSI: SDCARD.3, U$1.D11
unnamed: R1.2, T1.2 (B)
unnamed: SG1.-, T1.3 (C)
unnamed: R2.1, SG1.+
unnamed: LED1.A, R3.1
RX: GPS.3, U$1.RX1
RX1: CAMERA.3, U$1.D7
RX2: U$1.D2, XB1.2 (DOUT)
SCK: SDCARD.2, U$1.D13
SCL: BMP180.2, RTC.4, U$1.A5
SDA: BMP180.1, RTC.3, U$1.A4
SL: SV1.2
SS: SDCARD.1, U$1.D10
TX: GPS.2, U$1.TX0
TX1: CAMERA.2, U$1.D8
TX2: U$1.D9, XB1.3 (DIN/!CONFIG)
UP: MOTOR1.3, U$1.D6
VOUT: C1.1, IC1.1 (VI), R3.2, R4.1, SWITCH.2

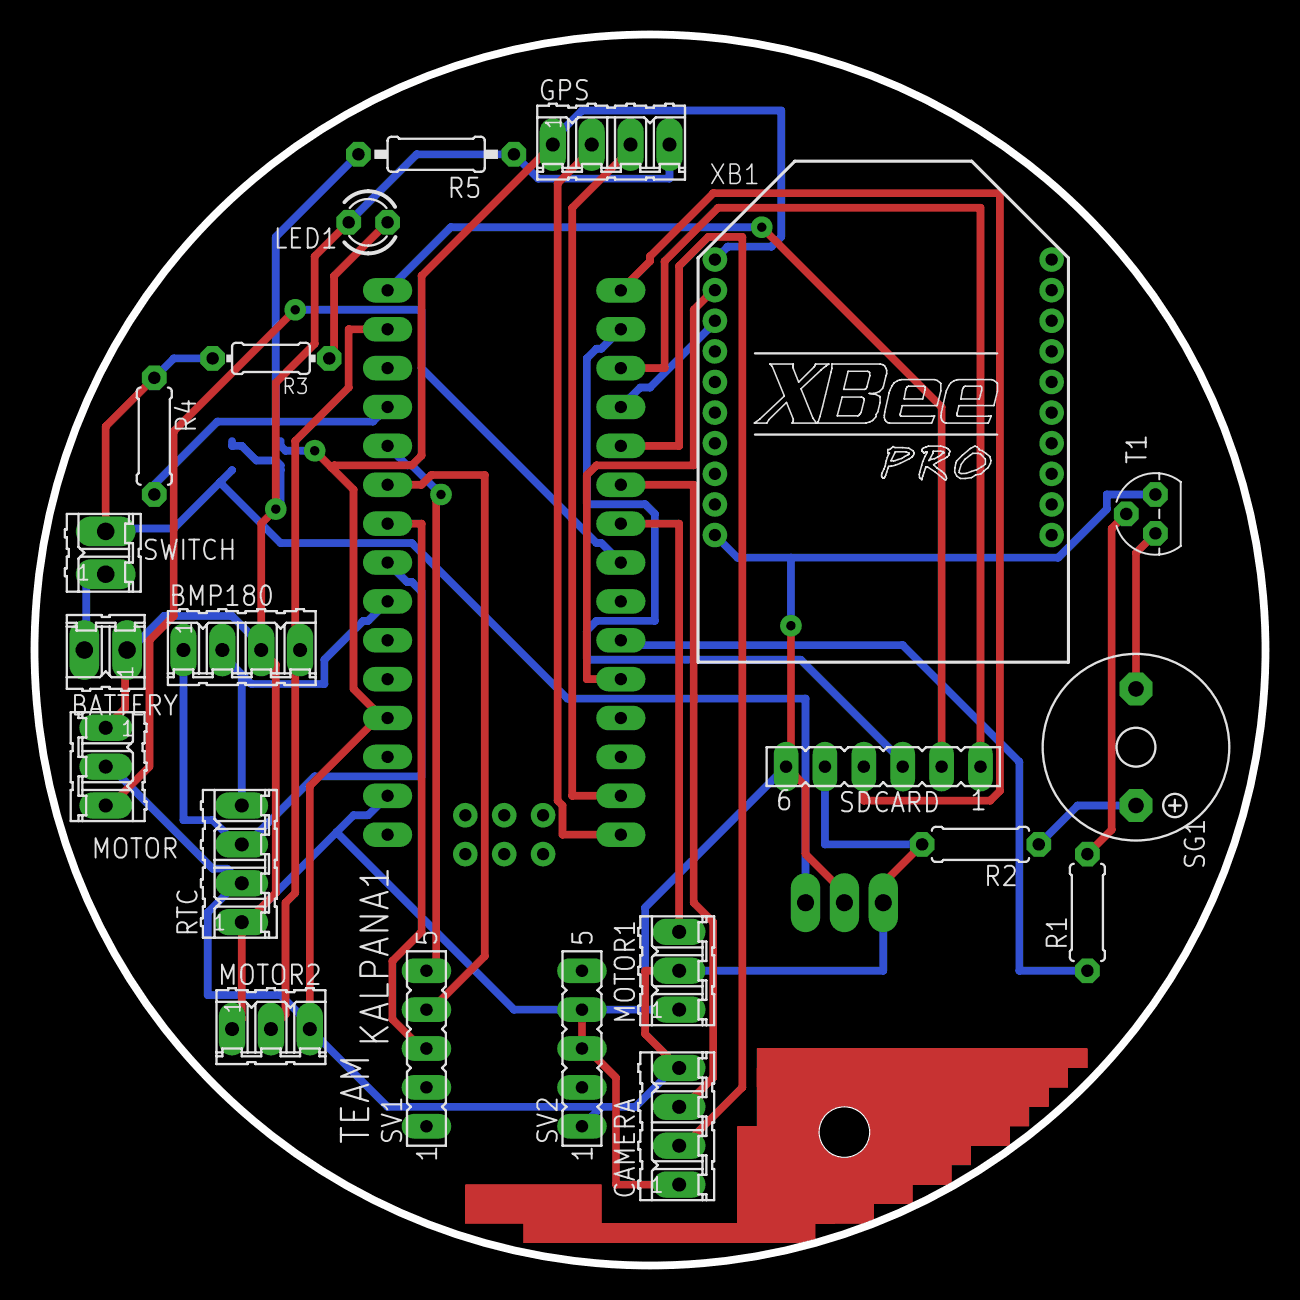
[picture p40: board Cansat 2018_V2 (1).brd from above]

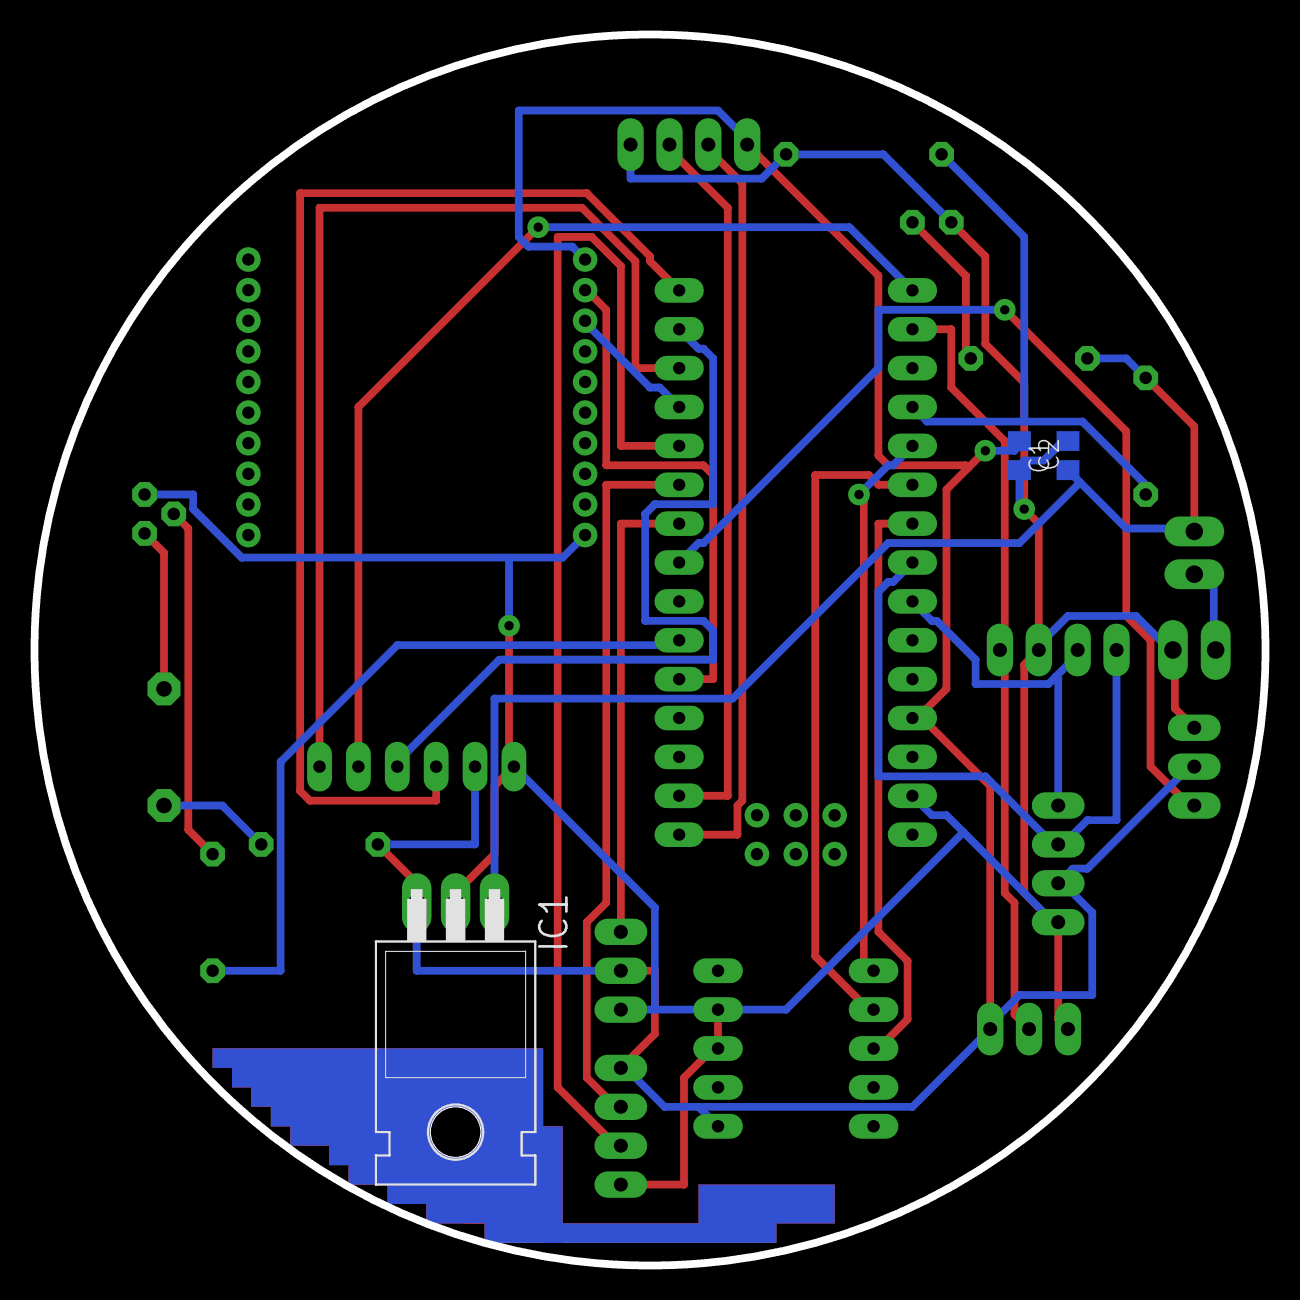
[picture p41: board Cansat 2018_V2 (1).brd from below]

Board: 2 copper layers, 80.4 x 80.4 mm, 25 parts (3 on the bottom side), 28 nets.
