orderinnchaoss/CANSAT-18/(commit log)

2018-11-05 Rename Cansat 2018_V2 (1).brd to SchBrds/Cansat 2018_V2 (1).brd
    [Cansat 2018_V2 (1).brd]
2018-11-05 Rename Cansat 2018_V2 (1).sch to SchBrds/Cansat 2018_V2 (1).sch
    [Cansat 2018_V2 (1).sch]
